Exadler/DualMotorControlCape/DMCC-Mk5-Layout.jpg

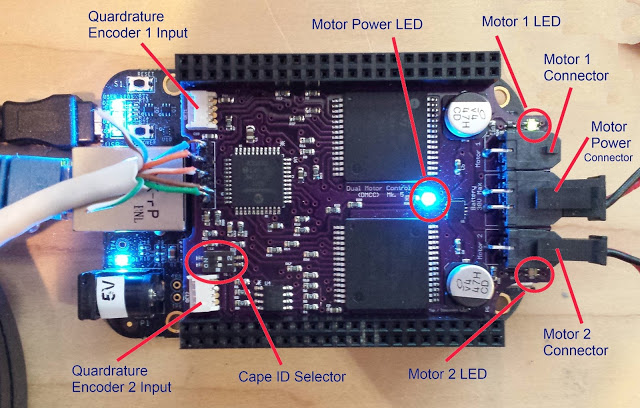
DMCC-Mk5-Layout.jpg
