Exadler/DualMotorControlCape/DualMotorCape-v7.pdf

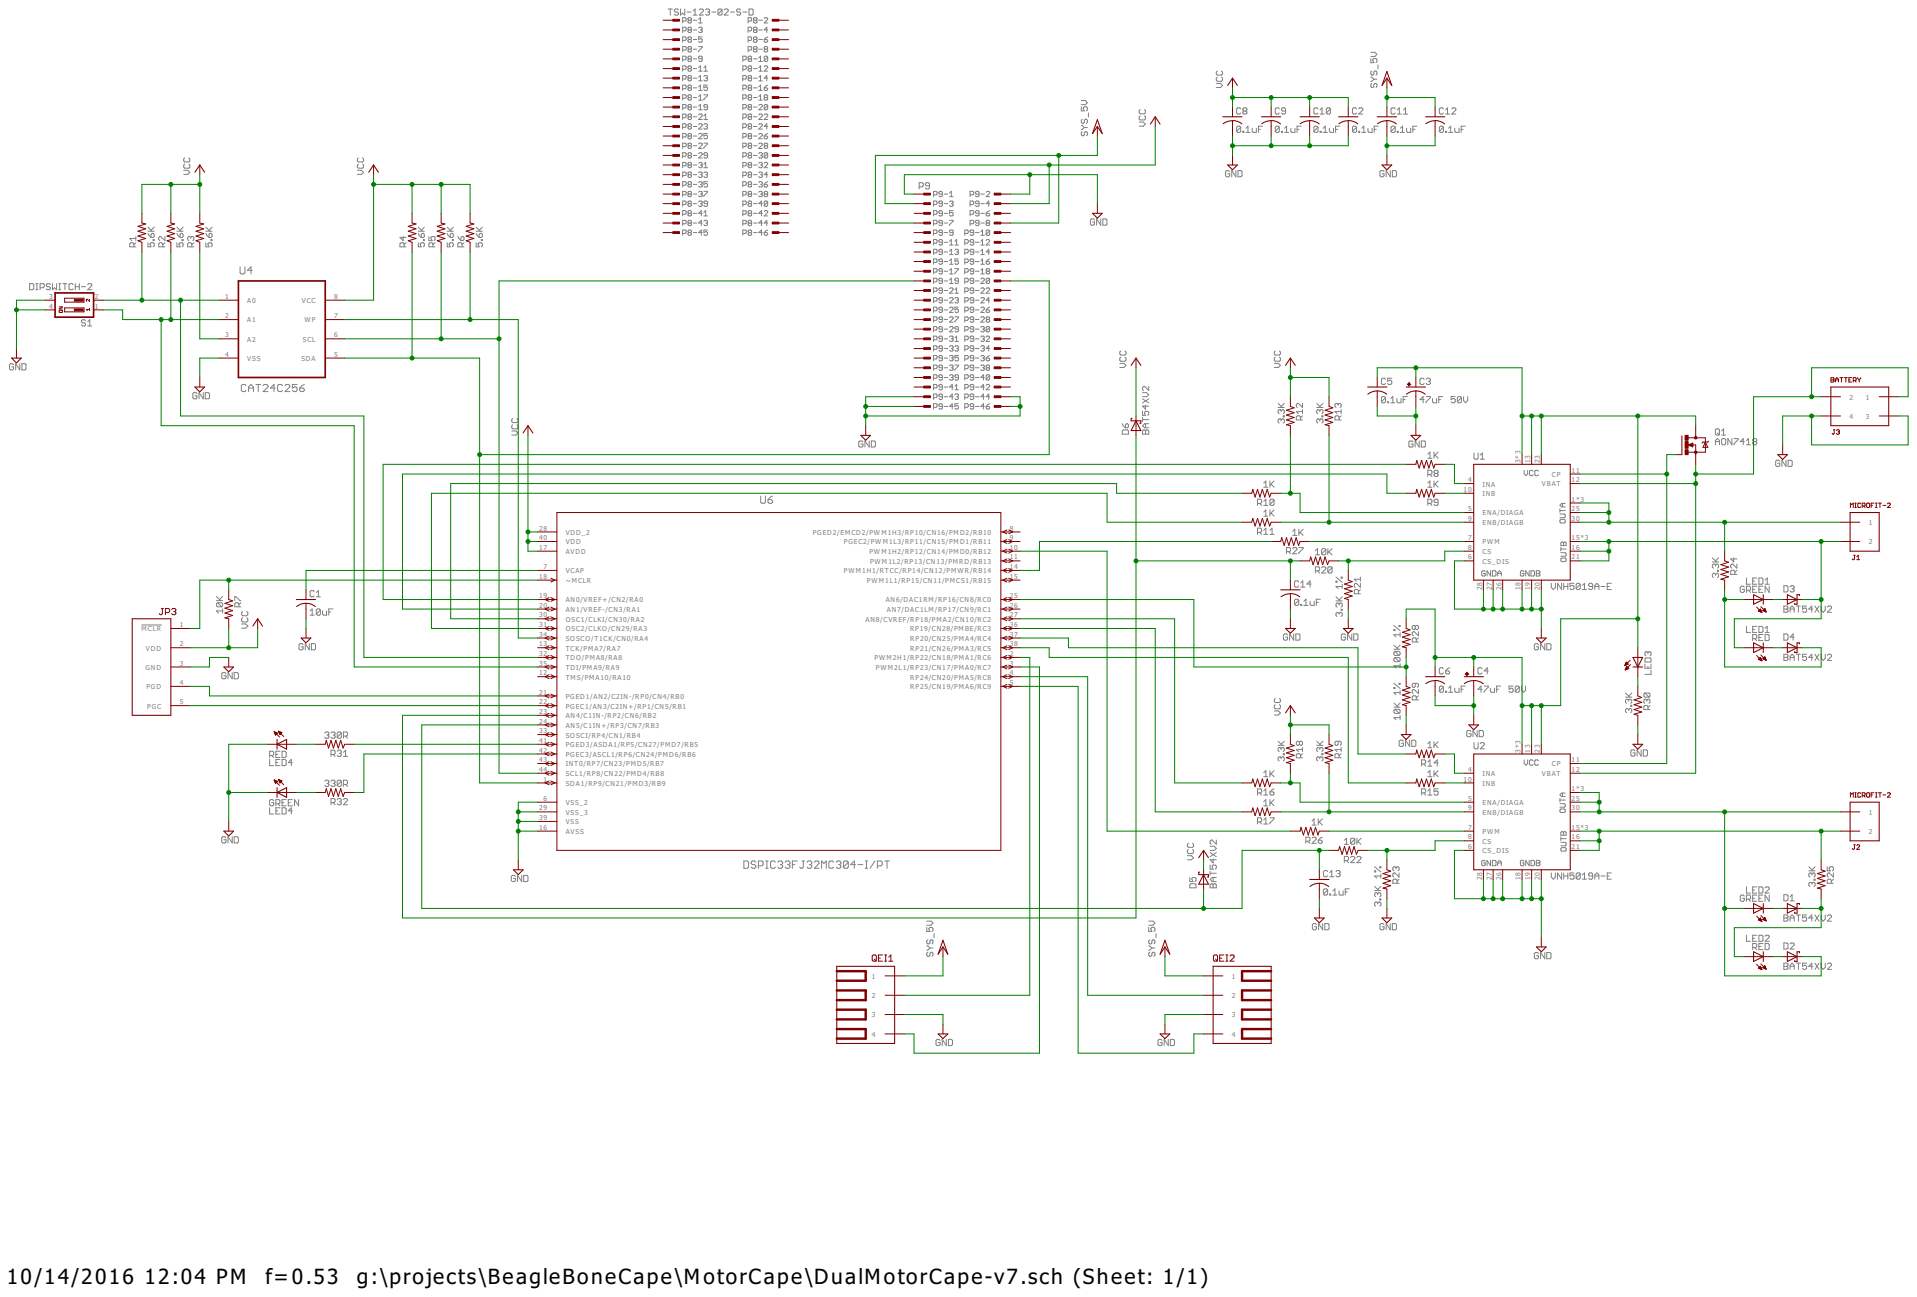
[picture p2: page 1]

10/14/2016 12:04 PM f=0.53 g:\projects\BeagleBoneCape\MotorCape\DualMotorCape-v7.sch (Sheet: 1/1)
