Exadler/DualMotorControlCape/DualMotorCape-v7.brd

## EAGLE design DualMotorCape-v7.brd (2016-10-14)

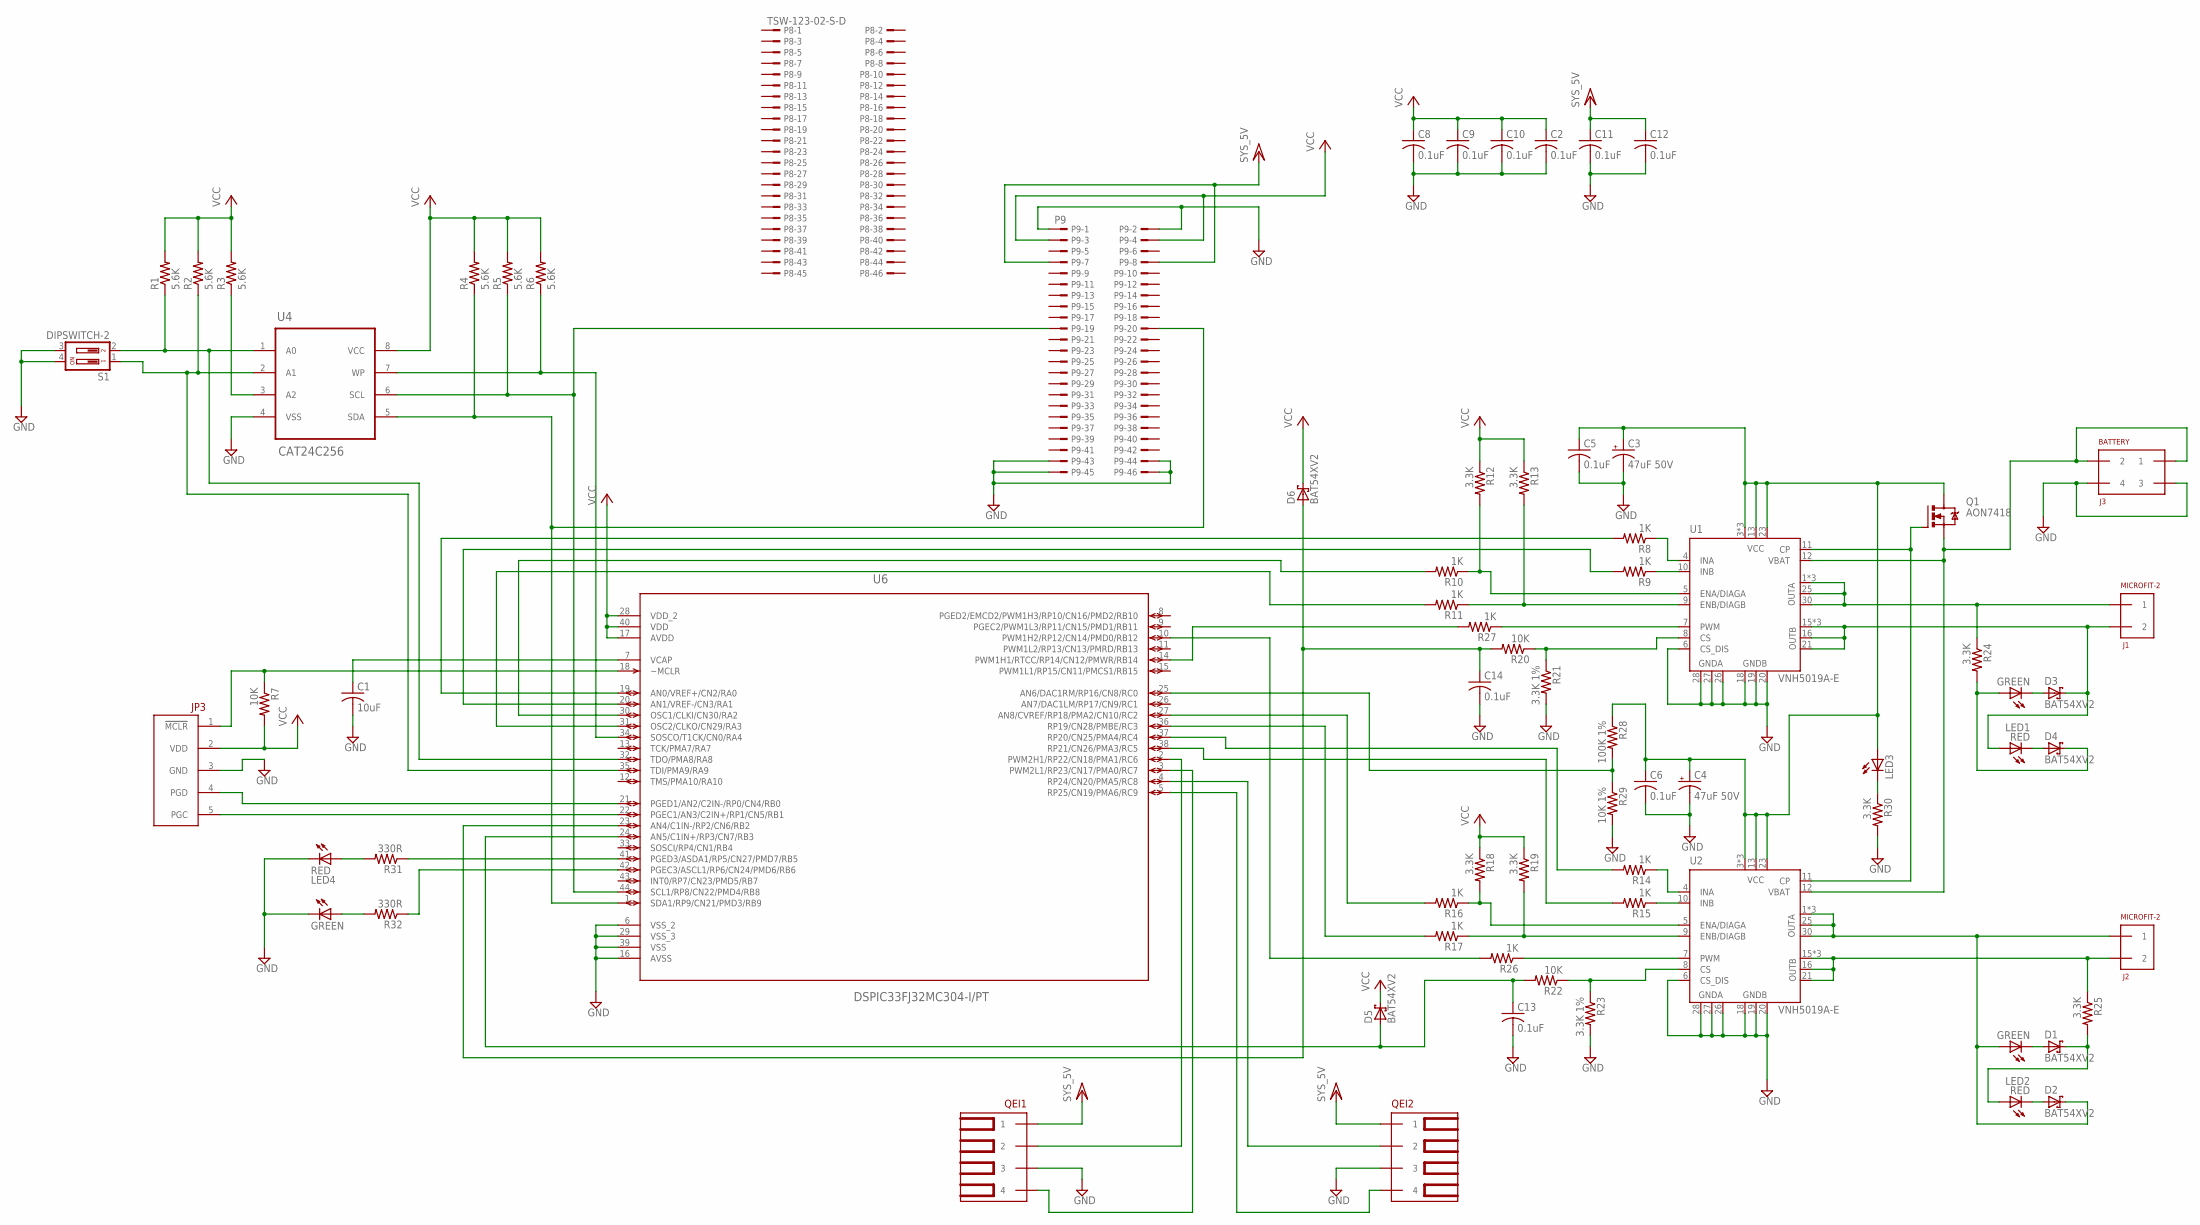
[picture p3: schematic DualMotorCape-v7.sch]

Parts:
C1: 10uF; C0805; MPN 08056C106KAT2A
C2, C5, C6, C8, C9, C10, C11, C12, C13, C14: 0.1uF; C0603; MPN 06035C104KAT2A
C3, C4: 47uF 50V; UD-8X10_NICHICON; MPN EEE-FK1H470XP; DIGIKEY 493-2303-1-ND
D1, D2, D3, D4, D5, D6: BAT54XV2; SOD523; MPN BAT54XV2; DIGIKEY# BAT54XV2CT-ND
J1, J2: MICROFIT-2; MICROFIT-2-R-TH
J3: BATTERY; MICROFIT-4-R-TH
JP3: ICD2/3-HEADER
LED1, LED2, LED4: KINGBRIGHT-BI-COLOR-LED; LED-1.6X1.5MM-BI-COLOR
LED3: LED-LNJP12X8ARA; LED-603-PANASONIC
P8: TSW-123-02-S-D
P9: P9; TSW-123-02-S-D
Q1: AON7418; DFN3.3X3.3
QEI1, QEI2: MOLEX-KK-22-15-2046-4PIN
R1, R2, R3, R4, R5, R6: 5.6K; R0603; MPN MC 0.063W 0603 1% 5K6
R7, R20, R22: 10K; R0603
R8, R9, R10, R11, R14, R15, R16, R17, R26, R27: 1K; R0603
R12, R13, R18, R19, R24, R25, R30: 3.3K; R0603; MPN CRCW06033K30FKEA
R21, R23: 3.3K 1%; R0603; MPN CRCW06033K30FKEA
R28: 100K 1%; R0603; MPN ASC0603-100KFT5
R29: 10K 1%; R0603; MPN CRCW060310K0FKTA
R31, R32: 330R; R0603
S1: DIPSWITCH-2; DIPSWITCH-218-2; DIGIKEY# CT2182LPST-ND
U1, U2: VNH5019A-E; MPN VNH5019A-E
U4: CAT24C256; SOIC-8; MPN CAT24C256WI-G
U6: DSPIC33FJ32MC304-I/PT; QFP80P1200X1200X120-44N; MPN DSPIC33FJ32MC304-I/PT

Connections:
GND: C1.2, C2.2, C3.-, C4.-, C5.2, C6.2, C8.2, C9.2, C10.2, C11.2, C12.2, C13.2, C14.2, J3.3 (4), J3.4 (3), JP3.3 (GND), LED4.2, LED4.4, P9.1, P9.2, P9.43, P9.44, P9.45, P9.46, QEI1.P$3 (3), QEI2.P$3 (3), R21.2, R23.2, R29.2, R30.2, S1.3, S1.4, U1.6 (CS_DIS), U1.18 (GNDB), U1.19 (GNDB), U1.20 (GNDB), U1.26 (GNDA), U1.27 (GNDA), U1.28 (GNDA), U2.6 (CS_DIS), U2.18 (GNDB), U2.19 (GNDB), U2.20 (GNDB), U2.26 (GNDA), U2.27 (GNDA), U2.28 (GNDA), U4.4 (VSS), U6.6 (VSS_2), U6.16 (AVSS), U6.29 (VSS_3), U6.39 (VSS)
M1+: J1.2 (1), R24.1, U1.1 (OUTA), U1.25 (OUTA), U1.30 (OUTA), U1.NC/OUTA (OUTA), U1.NC/OUTA@1 (OUTA)
M1-: D3.C, J1.1 (2), LED1.1, U1.15 (OUTB), U1.16 (OUTB), U1.21 (OUTB), U1.NC/OUTB (OUTB), U1.NC/OUTB@1 (OUTB)
M2+: D2.C, J2.2 (1), LED2.3, U2.1 (OUTA), U2.25 (OUTA), U2.30 (OUTA), U2.NC/OUTA (OUTA), U2.NC/OUTA@1 (OUTA)
M2-: J2.1 (2), R25.1, U2.15 (OUTB), U2.16 (OUTB), U2.21 (OUTB), U2.NC/OUTB (OUTB), U2.NC/OUTB@1 (OUTB)
unnamed: D4.C, LED1.3, R24.2
unnamed: LED3.2 (C), R30.1
unnamed: LED4.1, R31.2
unnamed: Q1.4 (G), U1.11 (CP), U2.11 (CP)
unnamed: LED4.3, R32.2
unnamed: JP3.1 (!MCLR), R7.1, U6.18 (~MCLR)
unnamed: R31.1, U6.41 (PGED3/ASDA1/RP5/CN27/PMD7/RB5)
unnamed: D3.A, LED1.4
unnamed: R3.1, U4.3 (A2)
unnamed: R6.1, U4.7 (WP), U6.34 (SOSCO/T1CK/CN0/RA4)
unnamed: P9.19, R5.1, U4.6 (SCL), U6.44 (SCL1/RP8/CN22/PMD4/RB8)
unnamed: P9.20, R4.1, U4.5 (SDA), U6.1 (SDA1/RP9/CN21/PMD3/RB9)
unnamed: JP3.5 (PGC), U6.22 (PGEC1/AN3/C2IN+/RP1/CN5/RB1)
unnamed: R32.1, U6.42 (PGEC3/ASCL1/RP6/CN24/PMD6/RB6)
unnamed: JP3.4 (PGD), U6.21 (PGED1/AN2/C2IN-/RP0/CN4/RB0)
unnamed: R11.1, R13.2, U1.9 (ENB/DIAGB)
unnamed: R10.1, R12.2, U1.5 (ENA/DIAGA)
unnamed: R27.2, U6.14 (PWM1H1/RTCC/RP14/CN12/PMWR/RB14)
unnamed: R8.1, U1.4 (INA)
unnamed: R9.1, U1.10 (INB)
unnamed: R15.1, U2.10 (INB)
unnamed: R14.1, U2.4 (INA)
unnamed: R17.2, U6.36 (RP19/CN28/PMBE/RC3)
unnamed: R22.1, R23.1, U2.8 (CS)
unnamed: R20.1, R21.1, U1.8 (CS)
unnamed: R10.2, U6.30 (OSC1/CLKI/CN30/RA2)
unnamed: R11.2, U6.31 (OSC2/CLKO/CN29/RA3)
unnamed: R14.2, U6.37 (RP20/CN25/PMA4/RC4)
unnamed: R15.2, U6.38 (RP21/CN26/PMA3/RC5)
unnamed: R16.2, U6.27 (AN8/CVREF/RP18/PMA2/CN10/RC2)
unnamed: QEI1.P$2 (2), U6.2 (PWM2H1/RP22/CN18/PMA1/RC6)
unnamed: QEI1.P$4 (4), U6.3 (PWM2L1/RP23/CN17/PMA0/RC7)
unnamed: R26.1, U2.7 (PWM)
unnamed: R28.2, R29.1, U6.25 (AN6/DAC1RM/RP16/CN8/RC0)
unnamed: D1.A, LED2.4
unnamed: R27.1, U1.7 (PWM)
unnamed: C1.1, U6.7 (VCAP)
unnamed: C3.+, C4.+, C5.1, C6.1, LED3.1 (A), Q1.5 (D), Q1.6 (D), Q1.7 (D), Q1.8 (D), Q1.9 (D), R28.1, U1.3 (VCC), U1.13 (VCC), U1.23 (VCC), U1.NC/VCC (VCC), U1.NC/VCC@1 (VCC), U2.3 (VCC), U2.13 (VCC), U2.23 (VCC), U2.NC/VCC (VCC), U2.NC/VCC@1 (VCC)
unnamed: D4.A, LED1.2
unnamed: D2.A, LED2.2
unnamed: D1.C, LED2.1, R25.2
PWM1H2: R26.2, U6.10 (PWM1H2/RP12/CN14/PMD0/RB12)
RA0: R8.2, U6.19 (AN0/VREF+/CN2/RA0)
RA1: R9.2, U6.20 (AN1/VREF-/CN3/RA1)
RB2: C14.1, D6.A, R20.2, U6.23 (AN4/C1IN-/RP2/CN6/RB2)
RB3: C13.1, D5.A, R22.2, U6.24 (AN5/C1IN+/RP3/CN7/RB3)
RB6: QEI2.P$2 (2), U6.4 (RP24/CN20/PMA5/RC8)
RB7: QEI2.P$4 (4), U6.5 (RP25/CN19/PMA6/RC9)
RC8: R1.1, S1.2, U4.1 (A0), U6.32 (TDO/PMA8/RA8)
RC9: R2.1, S1.1, U4.2 (A1), U6.35 (TDI/PMA9/RA9)
U2ENA: R16.1, R18.2, U2.5 (ENA/DIAGA)
U2ENB: R17.1, R19.2, U2.9 (ENB/DIAGB)
VBAT: J3.1 (2), J3.2 (1), Q1.1 (S), Q1.2 (S), Q1.3 (S), U1.12 (VBAT), U2.12 (VBAT)
VCC: C2.1, C8.1, C9.1, C10.1, D5.C, D6.C, JP3.2 (VDD), P9.3, P9.4, R1.2, R2.2, R3.2, R4.2, R5.2, R6.2, R7.2, R12.1, R13.1, R18.1, R19.1, U4.8 (VCC), U6.17 (AVDD), U6.28 (VDD_2), U6.40 (VDD)
VCC/2: C11.1, C12.1, P9.7, P9.8, QEI1.P$1 (1), QEI2.P$1 (1)

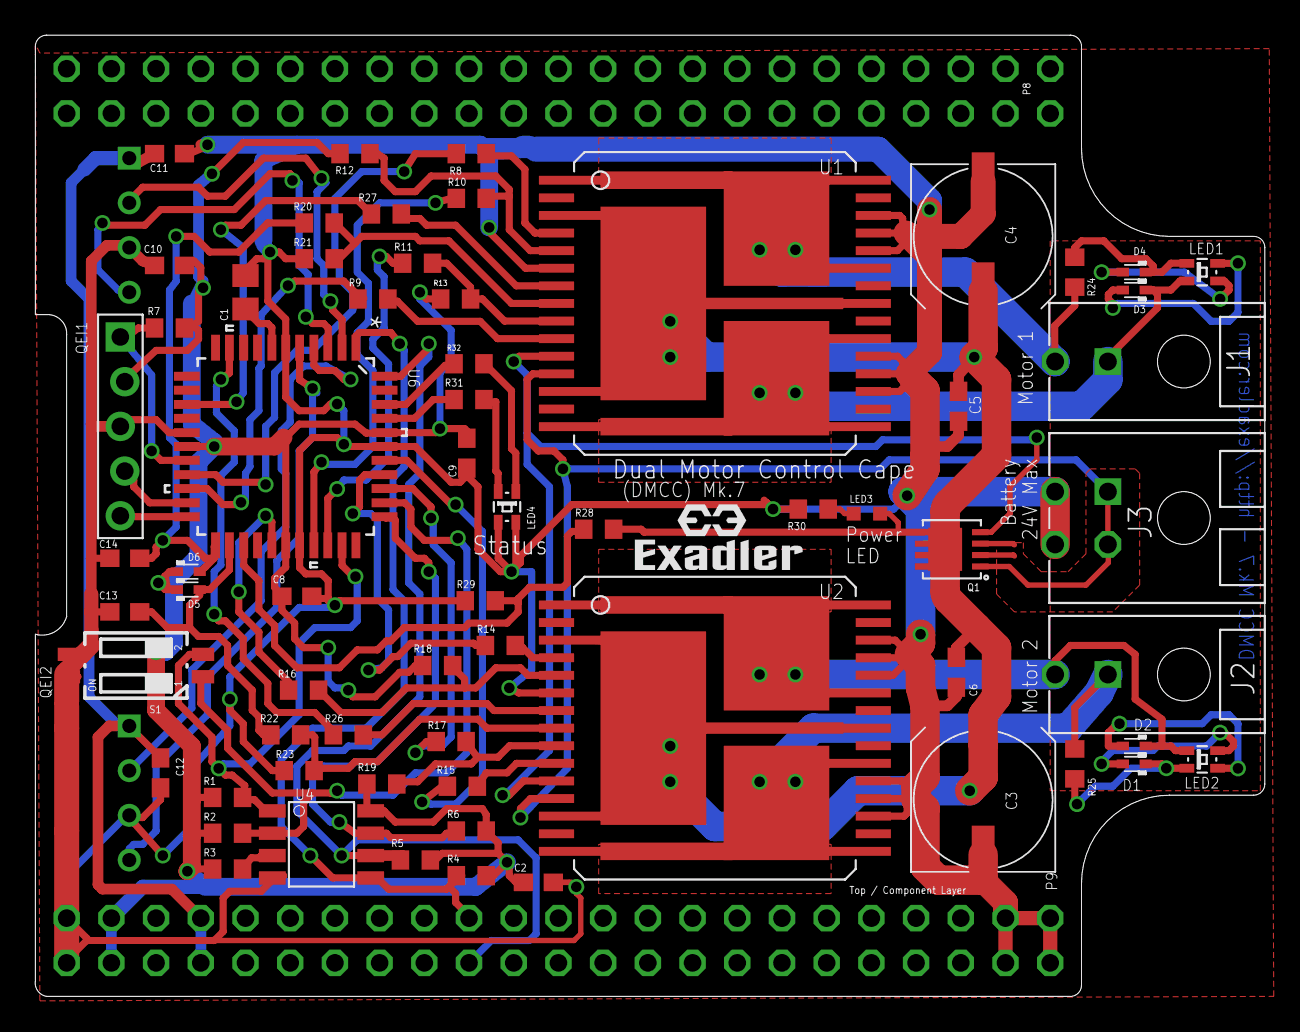
[picture p4: board DualMotorCape-v7.brd from above]

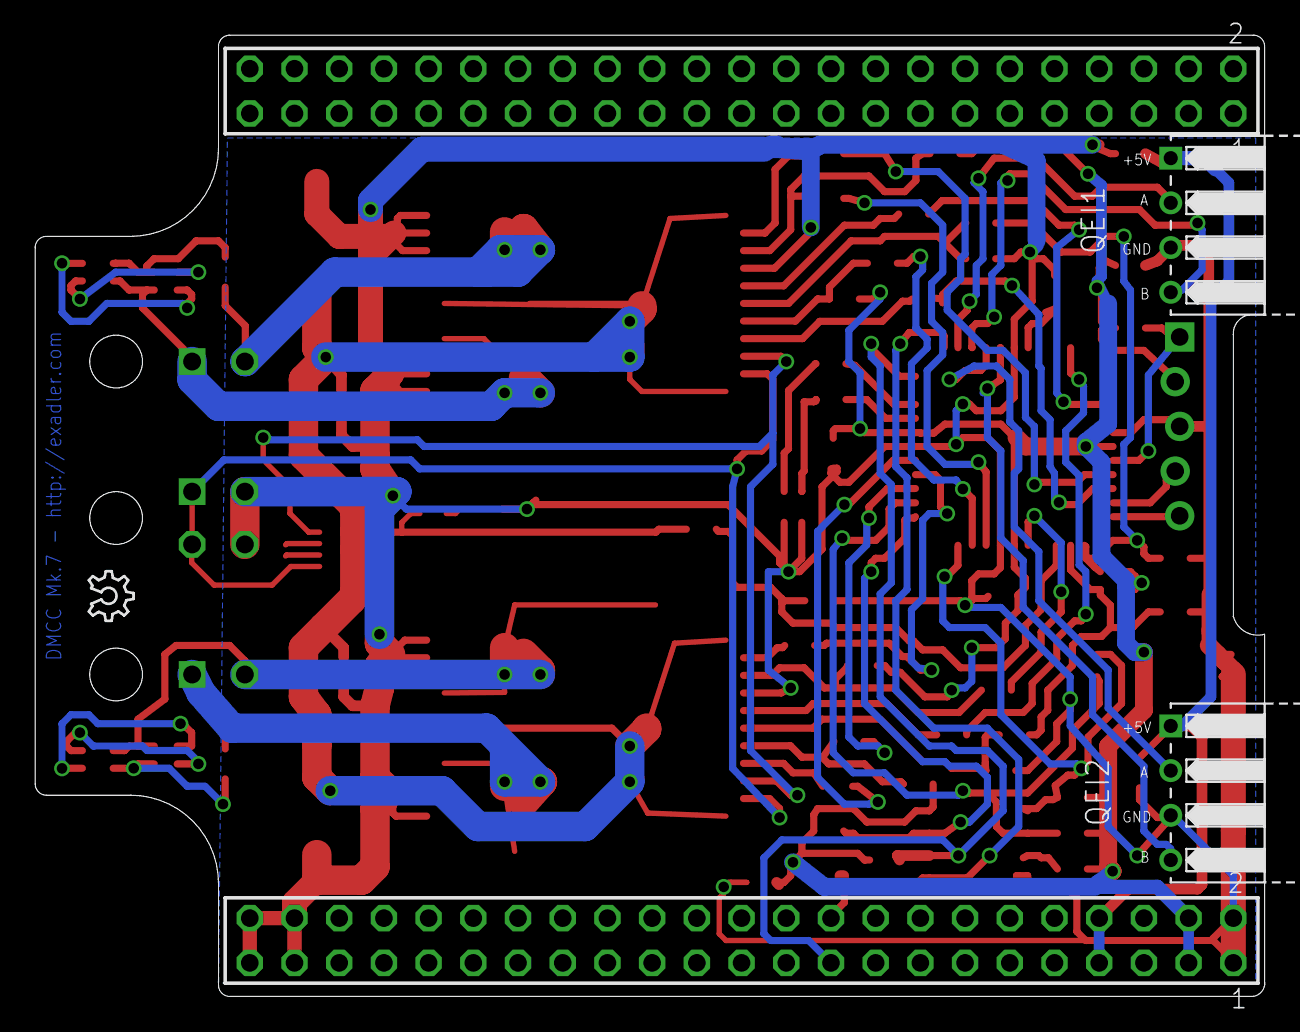
[picture p5: board DualMotorCape-v7.brd from below]

Board: 2 copper layers, 69.9 x 54.6 mm, 71 parts (4 on the bottom side), 60 nets.

Other parts of the board:
U$1: EXADLER-LOGO
U$2: OSHW_6X100_NOTEXT
