Exadler/DualMotorControlCape/(commit log)

2012-12-23 Version 1.0
    Release 1.0 of Dual Motor H-Bridge with dual QEI - BeagleBone Cape
    [DualMotorCape-v1.brd, DualMotorCape-v1.prt, DualMotorCape-v1.sch]
2012-12-23 Added PDF of schematic
2012-12-24 Created BOM in .xls format
    Total cost (QTY 100) is 26.4392
    [DualMotorCape-v1.prt, DualMotorCape-v1.xls]
2012-12-24 Updated BOM
    [DualMotorCape-v1.xls]
2013-07-25 DMCC Mk.6 release
    [DualMotorCape-v6.brd, DualMotorCape-v6.sch]
2016-10-14 V7 files and PDF of schematic
    [DualMotorCape-v7.brd, DualMotorCape-v7.sch]
